Cfpintog/-Controlador-MIDI-movimiento-dedos-2016-2/README.md

# -Controlador-MIDI-movimiento-dedos-2016-2
Implementación de controlador MIDI en LM32
