Cfpintog/-Controlador-MIDI-movimiento-dedos-2016-2/proyecto-final-guante.pdf

UNIVERSIDAD NACIONAL DE COLOMBIA, DEPARTAMENTO DE INGENIERÍA ELECTRICA Y ELECTR ´ | ONICA, ELECTR ´ | ONICA DIGITAL II | 1 ´

# Proyecto Final: Guante MIDI

David Burbano, Miguel Perez, Carlos Pinto (daaburbanola@unal.edu.co, migaperezber@unal.edu.co, cfpintog@unal.edu.co)

I. INTRODUCCION´

La especificacion MIDI (Musical Interface Digital ´
Interface) surge en 1983 como un estandar t ´ | ecnico universal ´
que permitiera la comunicacion y conexi ´ | on entre equipos ´
profesionales de audio, independientemente del fabricante. Mediante un protocolo de comunicacion serial, compuesto por ´
tres bytes, fue posible el envío y recepcion de informaci ´ | on´
asociada a un instrumento musical específico, su volumen (velocity), tono, paneo, etc.
En principio este protocolo fue concebido para instrumentos musicales cuyas características de diseno digital consistiera en ˜ Hardware, sin embargo, debido a un desarrollo paralelo de los computadores personales como instrumentos de produccion´
de audio, el protocolo MIDI tomo un enfoque de co-dise ´ | nõ
HW/SW que resulta interesante para el objetivo del curso.
II. | DESCRIPCION DEL DISPOSITIVO ´ | .

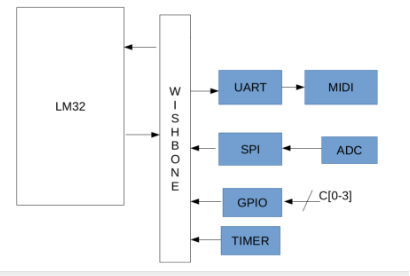
[picture p1: figure]

Figura 1. Bloque estructural

El dispositivo se plantea como un instrumento musical en el cual la activacion de las notas se hace por medio ´ de movimiento de los dedos, usando un guante que tendrá incorporado sensores fotoelectricos, dispuestos de tal forma ´ que capten el movimiento de los dedos del usuario.
Una vez captada la posicion de los dedos, esta es procesada ´ para luego ser enviada a modo de mensaje de protocolo MIDI, el cual es transmitido por medio de UART a un circuito acondicionador, el cual eleva los niveles logicos ´ característicos de la FPGA a los 5V logicos necesarios para ´ el funcionamiento del sistema MIDI, mensajes que seran´ interpretados por una interfaz para luego ser reenviados a el dispositivo de reproduccion. ´
Debido a las características del protocolo MIDI ya que es el protocolo usado de manera profesional para aplicaciones musicales de alta fidelidad, se cuentan con diversas opciones, tales como cambiar el paneo (Distribucion espacial del ´ sonido), la velocidad de la nota, el instrumento a emular en el dispositivo reproductor de sonido y se puede variar entre 127 notas diferentes.
En nuestro caso en especifico se cuenta con la seleccion de ´ 8 distintas notas, estas debido a las diferentes combinaciones
posibles de los dedos indice, corazon, anular y me ´ | nique; ˜
Ademas se cuenta con la opcion de cambiar el nivel de ´ volumen, esta senal depende del valor medido en un potencio ˜ metro, el cual es cambiado a valores digitales por medio de un conversor Analogo-Digital, el cual se comunica con la FPGA por medio de protocolo SPI, y de la misma manera que la nota, es enviado por medio de MIDI a el dispositivo de reproduccion. ´

III. ESPECIFICACIONES SOFTWARE/HARDWARE

A continuacion se presenta informaci ´ | on detallada sobre las ´
especificaciones HW/SW del proyecto.

Especificaciones de Software

Analisis de se ´ | nales provenientes de sensores: ˜

Uno de los aspectos fundamentales del proyecto consiste en
que al recibir una senal espec ˜ | ífica de un actuador, el sistema
este en capacidad de analizar dicha se ´ | nal, saber de d ˜ | onde ´
proviene, y realizar una tarea específica a partir del analisis ´ de la misma. En este caso la senal el ˜ ectrica proveniente del ´ ADC es digitalizada, y posteriormente enviada a la FPGA. El
analisis de la se ´ | nal y la ejecuci ˜ | on de una acci ´ | on espec ´ | ífica
son procesos que resultan mas viables desde una perspectiva ´ de diseno de software. En este caso, el procesador montado en ˜ la FPGA debe estar en la capacidad de determinar la intensidad (o nivel) de la senal proveniente del sensor, y a partir de esto ˜ asignar un nivel del volumen.
Adicionalmente, considerando que el proyecto hace uso de cuatro fototransistores anadidos al guante, el software debe ˜ estar en capacidad de determinar el origen de la senal digital. A ˜ partir de este analisis se decide que nota se asigna identificadas ´ con un valor en el protocolo MIDI.

Especificacion de Hardware ´
Perifericos para ADC: La conversi ´ | on de se ´ | nales anal ˜ | ogicas ´
y digitales requiere de la utilizacion de circuitos integrados ´ que pasen del dominio discreto digital, al dominio continuo analogo y viceversa. Para el caso de los conversores ADC, ´ basta con la utilizacion de circuitos ADC de 8 bits. Esto debido ´ a que el protocolo MIDI tiene un rango de maximo 7 bits para ´ el nivel (velocity).

UNIVERSIDAD NACIONAL DE COLOMBIA, DEPARTAMENTO DE INGENIERÍA ELECTRICA Y ELECTR ´ | ONICA, ELECTR ´ | ONICA DIGITAL II | 2 ´

Los demas elementos de hardware van asociados a los ´
perifericos de comunicacion usados: ´
SPI
UART
GPIO
TIMER

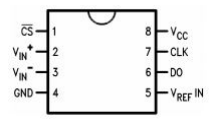
[picture p2: figure]

Figura 2. IC del conversor Analogo-Digital ADC08031. ´

IV. PERIFERICOS UTILIZADOS ´ | , DESCRIPCION Y ´

FUNCIONAMIENTO.

UART

La UART (Universal Asynchronous Receiver/Transmitter) corresponde a un Hardware que traduce informacion de serial ´ a paralelo y viceversa. Lo anterior quiere decir que la UART
toma informacion paralela en forma de Bytes, y env ´ | ía bit por
bit de esta informacion de manera secuencial. ´
Esto implica la definicion de ciertas condiciones de manera ´ que tanto emisor como receptor puedan comunicarse de
manera adecuada. Primero, la comunicacion es as ´ | íncrona,
esto significa que no existe una senal de reloj com ˜ | un entre ´
las dos partes que se comunican. Segundo, se requieren bits de inicio y de parada de manera que las dos partes sepan en
que momento se da inicio y finalizacion a la transmisi ´ | on de ´
datos. Tercero, se utiliza un unico lazo para la transmisi ´ | on´
y recepcion de informaci ´ | on, lo que significa que no existe ´
ninguna de las partes actua como maestro o esclavo. ´
Para el proyecto se parte de una UART disenada previamente ˜ teniendo en cuenta la compatibilidad con el Wishbone del LM32, este periferico se implemento para lograr la ´ transmision del mensaje MIDI; mensaje que puede ser ´ transmitido por medio de una interfaz MIDI o por medio de bluetooth usando el modulo HC-06, pero dicha transmision´ no puede ser reconocida por la dificultad para cambiar la velocidad de transmision de datos por parte del modulo ´ de bluetooth ya que MIDI utiliza una velocidad de 31250 baudios.
En la figura IV se puede observar el diagrama funcional de UART en donde vemos las senales involucradas tanto ˜
en el proceso de transmision como en recepci ´ | on, en el ´
caso especifico de esta aplicacion solo es usada la funci ´ | on´
de UART-tx, ya que este periferico solo es usado para ´ transmision del mensaje MIDI; Ademas que la frecuencia de ´
envio debi ´ | o ser dispuesta a 31250 baudios. ´

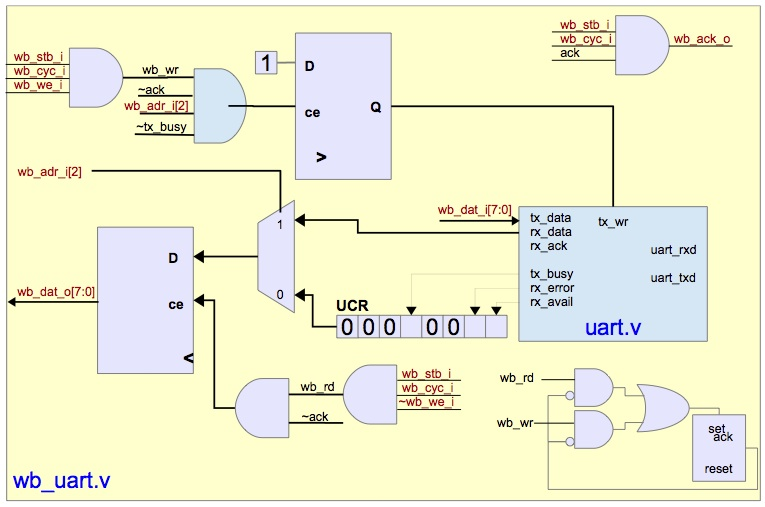
[picture p3: figure]

Figura 3. Diagrama logico de perif ´ | erico UART. ´

SPI
Para el correcto funcionamiento del proyecto es necesario recibir de manera adecuada una senal an ˜ aloga proveniente del ´ control de volumen, para esto se hace necesaria la implemen-tacion de un conversor AD, usando el ADC0831 el cual tiene ´ una salida serial y se comunica con el procesador por medio de protocolo SPI.
El SPI tiene una comunicacion s ´ íncrona y utiliza líneas sepa-radas para los datos y el reloj que mantiene a ambos lados en sincronía. Cuenta con 4 senales propias, CLK (reloj), la ˜
senal MOSI (Master Output - Slave Input), la se ˜ | nal MISO ˜
(Master Input - Slave Output) y un SS (select Slave) o CS. Al producirse una senal de reloj es seleccionado el esclavo ˜ con la senal SS, la cual al estar inactiva se encuentra en un ˜ estado logico alto y en el momento en el que es seleccionado ´
un esclavo la senal SS se pone en estado bajo. Las l ˜ | íneas de
datos son enviadas en orden. Primero el dato de transmision, ´
aquel que va por la sena MOSI, y luego el dato de recepci ˜ | on´
que va por la senal MISO. Este proceso descrito anteriormente ˜ se ilustra en la figura IV.

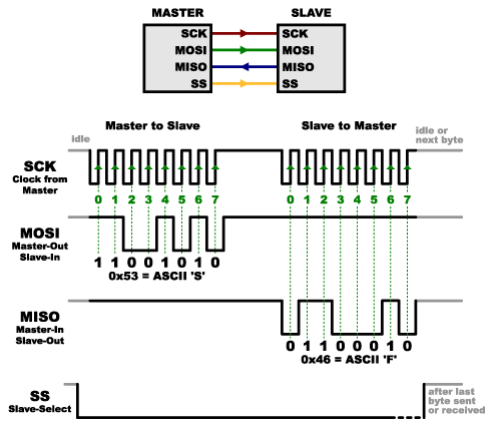
[picture p4: figure]

Figura 4. Diagrama de transmision SPI. ´

Timer
El periferico TIMER es un hardware que permite al usuario ´ implementar un control para la generacion de bases de tiem- ´ pos. Tiene la capacidad de realizar funciones como medicion´ de frecuencia, conteo de eventos, conteo de intervalos, generacion de reloj. etc. En la figura se observa la estructura del ciclo ´

UNIVERSIDAD NACIONAL DE COLOMBIA, DEPARTAMENTO DE INGENIERÍA ELECTRICA Y ELECTR ´ | ONICA, ELECTR ´ | ONICA DIGITAL II | 3 ´

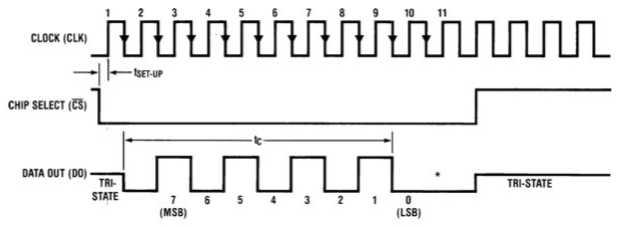
[picture p5: figure]

Figura 5. Funcionamiento 0831.

de lectura y escritura del periferico TIMER. Este perif ´ | erico ´
posee 6 registros y la posibilidad de leer al tiempo estas 6 variables. El timer cuenta con un contador, un comparador y un “tcr” de 32 bits, este registro contiene los bits EN, AR, IRQEN Y TRIG, los cuales corresponden a bits de control. El registro compare (comparador) de 32 bits contiene el tiempo o dato en el que se ha definido el retraso, de esta forma, al obtener el valor de compare, se activa el bit EN el cual inicia el conteo. Una vez el contador alcanza el valor compare se activa el bit AR y se reinicia el contador en 1. las variables son
posteriormente enviadas al wishbone por la senal wb ˜ | dat o.
En la fig. 12 se muestra el funcionamiento del periferico ´ TIMER. Para el desarrollo del proyecto, se implemento un ´ timer o retraso en los mensajes de desactivacion de nota, con ´ el objetivo de permitir que la nota o sonido sea reproducida durante un tiempo mas largo, de lo contrario la nota solo ´ duraría el tiempo que el procesador toma en leer el mensaje
de desactivacion de nota lo cual equivaldr ´ | ía a un tiempo muy
pequeno. ˜

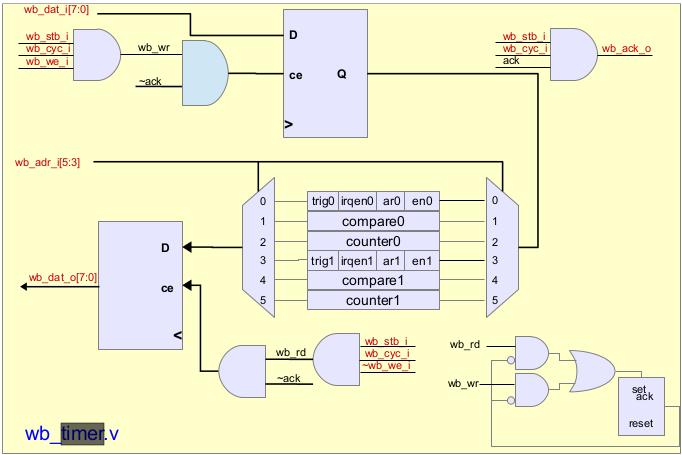
[picture p6: figure]

Figura 6. Comunicacion Perif ´ | erico TIMER- Lm32 ´

GPIO
El periferico GPIO es un perif ´ | erico de pines de entrada y ´
salida de proposito general. Permite controlar la direcci ´ | on de ´
un pin, controlar el valor de un pin de salida y leer el valor de un pin de entrada. En la siguiente figura se muestra el funcionamiento interno del periferico GPIO. ´
Para el desarrollo del proyecto se implemento un GPIO que ´ a traves de unos interruptores en la tarjeta de desarrollo per- ´ mita cambiar de instrumentos de acuerdo con la especificacion´ midi. Esto con el objetivo de que el proyecto no tenga solo funcionalidad de batería sino que tambien pueda sonar como ´ diferentes instrumentos seleccionados a traves del GPIO. Una ´ de las importantes capacidades del GPIO es la capacidad de leer valores de entrada (por lo general alto = 1, bajo = 0).

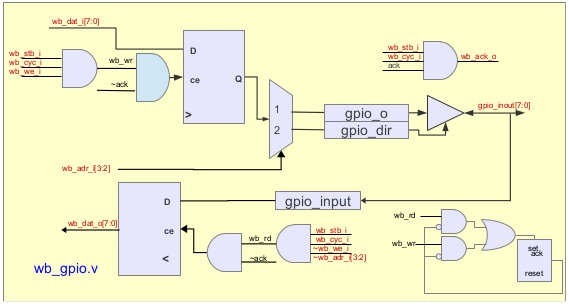
[picture p7: figure]

Figura 7. Comunicacion Perif ´ | erico GPIO- Lm32 ´

Teniendo en cuenta esta funcionalidad, para este GPIO se utilizaron 8 interruptores de la Nexys 4, estos 8 interruptores corresponden cada uno a un bit ( sea 0 o 1) seleccionado a partir del usuario, lo cuales permiten un rango de 0-255 en numero binario que corresponde en total a 255 diferentes ´ sonidos de instrumentos musicales.

V. PROTOCOLO MIDI

MIDI (abreviatura de Musical Instrument Digital Interface)
es un estandar tecnol ´ | ogico que describe un protocolo, ´
una interfaz digital y conectores que permiten que varios instrumentos musicales electronicos, computadoras y otros ´ dispositivos relacionados se conecten y comuniquen entre sí.1 Una simple conexion MIDI puede transmitir hasta ´
dieciseis canales de informaci ´ | on que pueden ser conectados ´
a diferentes dispositivos cada uno.

El sistema MIDI lleva mensajes de eventos que especifican
notacion musical, tono y velocidad; se ´ | nales de control para ˜
parametros musicales como lo son la din ´ | amica, el vibrato, ´
paneo, cues y senales de reloj que establecen y sincronizan el ˜ tempo entre varios dispositivos. Estos mensajes son enviados mediante un cable MIDI a otros dispositivos que controlan
la generacion de sonidos u otras caracter ´ | ísticas. Estos datos
tambien pueden ser grabados en un hardware o software ´ llamado secuenciador, el cual permite editar la informacion y ´ reproduciría posteriormente.
Un mensaje MIDI es una instruccion que controla alg ´ | un´
aspecto del dispositivo receptor. Un mensaje MIDI consiste en un byte de estatus, el cual indica el tipo del mensaje, seguido de dos bytes de datos que contienen los parametros.20 ´ Los mensajes MIDI pueden ser ”mensajes de canal”, los cuales son enviados a unos de los dieciseis canales y puede ´ ser escuchado solo por los dispositivos en ese canal, o ”mensajes de sistema”, los cuales pueden ser escuchados por todos los dispositivos. Cualquier dato no relevante para un dispositivo receptor es ignorado.37 :384 Existen cinco tipos de mensajes: Ç hannel Voice”, Ç hannel Mode”, ”System Common”, ”System Real-Time ²
”System Exclusive” En
la figura V podemos observar la conexion con la interfaz ´ MIDI, la cual como se observa parte de la senal proveniente ˜ de UART enviada por el procesador que se pasa por un amplificador dc-dc en el cual la senal es elevada a los valores ˜
logicos admitidos por MIDI, y se realiza la conexi ´ | on a el ´

UNIVERSIDAD NACIONAL DE COLOMBIA, DEPARTAMENTO DE INGENIERÍA ELECTRICA Y ELECTR ´ | ONICA, ELECTR ´ | ONICA DIGITAL II | 4 ´

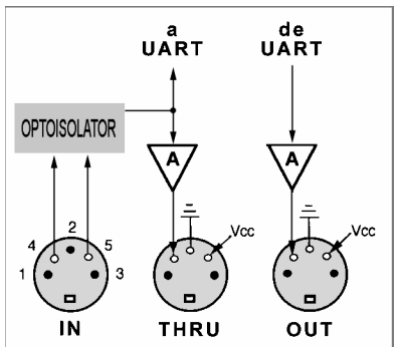
[picture p8: figure]

Figura 8. Esquema de conector MIDI

dispositivo, el cual tiene 5 pines, de los cuales solo se usan 3. Con respecto al mensaje MIDI, este esta compuesto por

Figura 9. Mensaje MIDI

3 bytes, como se indica en la figura V en los cuales el primer byte indica el tipo de mensaje a ser enviado, y los siguientes dos son para transmitir los datos, por ejemplo,
para la activacion de una nota el primer byte indicar ´ | ía que se
quiere activar una nota, el segundo el numero de la nota(mirar figura V), y el tercero su velocidad.
Para la transmision del mensaje MIDI, se emplea de la forma ´

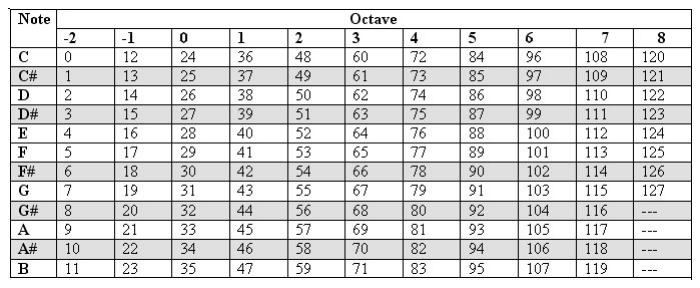
[picture p9: figure]

Figura 10. Tabla de notas protocolo MIDI

especificada en V:

Figura 11. Mensaje midi para activaccion de nota ´

Donde el valor 0x90 representa el mensaje de la activacion´ de una nota en el canal 0. El siguiente Byte corresponde a la nota seleccionada por el guante, finalmente el ultimo byte especifica la velocidad de ataque que indica que tan fuerte se esta presionando una tecla. Por defecto este valor se coloca en 0x40, para desactivar una nota se envía un 0x00 en este byte.

Para el cambio de volumen se emplea el mensaje especificado en V.

Figura 12. Mensaje midi para variacion de volumen ´

El primer byte representa un mensaje de cambio de control, que permite interactuar de distintas maneras con la calidad del sonido. El segundo byte corresponde al tipo de control que se va a emplear, en este caso es un cambio de volumen. Finalmente el ultimo byte corresponde al valor del volumen de la nota.
