Cfpintog/-Controlador-MIDI-movimiento-dedos-2016-2/proyecto digital 1.0.pdf

# Controlador MIDI aplicado al movimiento de los dedos

## David Burbano Miguel Pérez Carlos Pinto

## Descripción:

Se plantea el diseño de un un instrumento musical, el cual permite al usuario interactuar con el equipo por medio de un guante.
Y mediante el movimiento de sus dedos activar diferentes sonidos, con una frecuencia y tono diferente para cada uno de los dedos; lo cual permitirá al usuario por medio de diferentes combinaciones de movimientos crear distintas melodías y ritmos.

## Especificaciones del sistema

El dispositivo debe ser capaz de realizar las siguientes operaciones:

-Sensado del movimiento de cada uno de los dedos del usuario.

-Tener la posibilidad de elegir entre 3 tipos de instrumento.

-Por medio de UART se debe realizar el envío de mensajes al sistema MIDI

-Debe reproducirse el sonido elegido en los amplificadores de audio de un PC

## Componentes

Procesador LM32

5 sensores (infrarrojo) [S0-S4] (flexión- extensión)

1 Sensor (fotodetector)

1 Conmutador (selección de instrumento)[C0-C3]

## Modo de operación

Se determina el tipo de instrumento a interpretar C1, C2, C3

Se lee los valores de los sensores [s0-s4] y se selecciona la nota dependiendo del valor en la tabla.

A partir de la lectura del valor del ADC se determina el volumen de la nota.

Se transmiten los datos por UART.

## Diagrama estructural

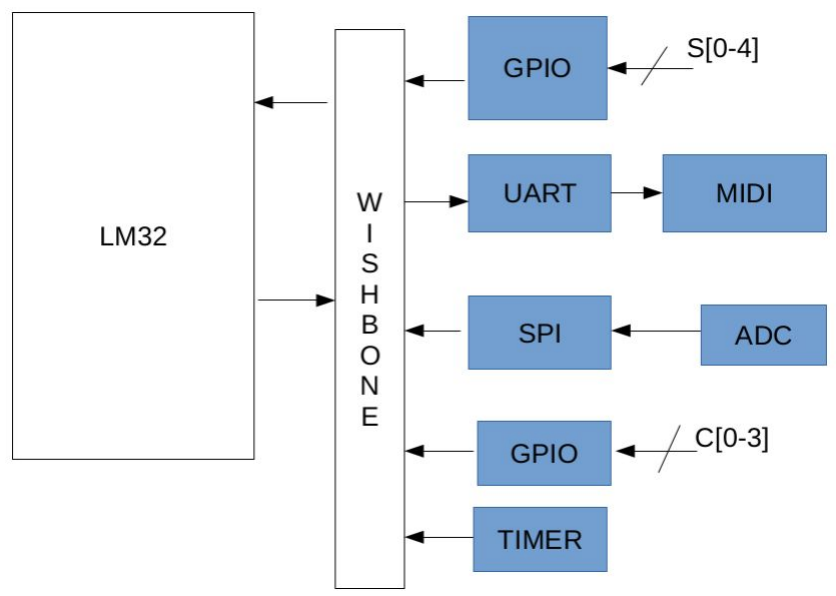
[picture p10: figure]

## Diagrama funcional(instrumento)

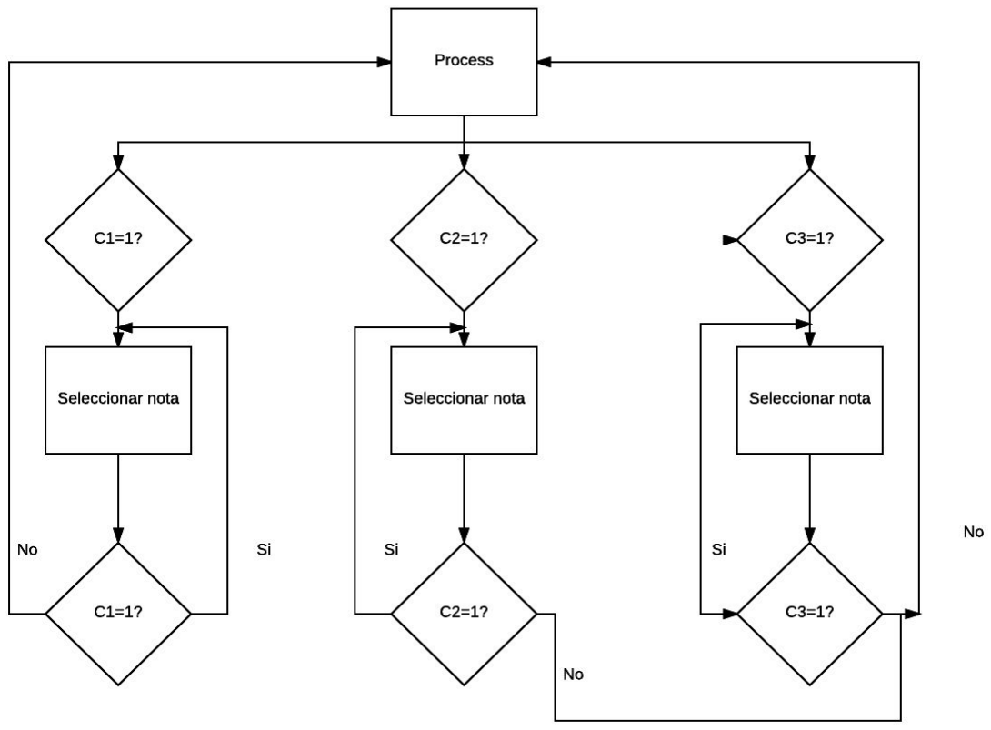
[picture p11: figure]

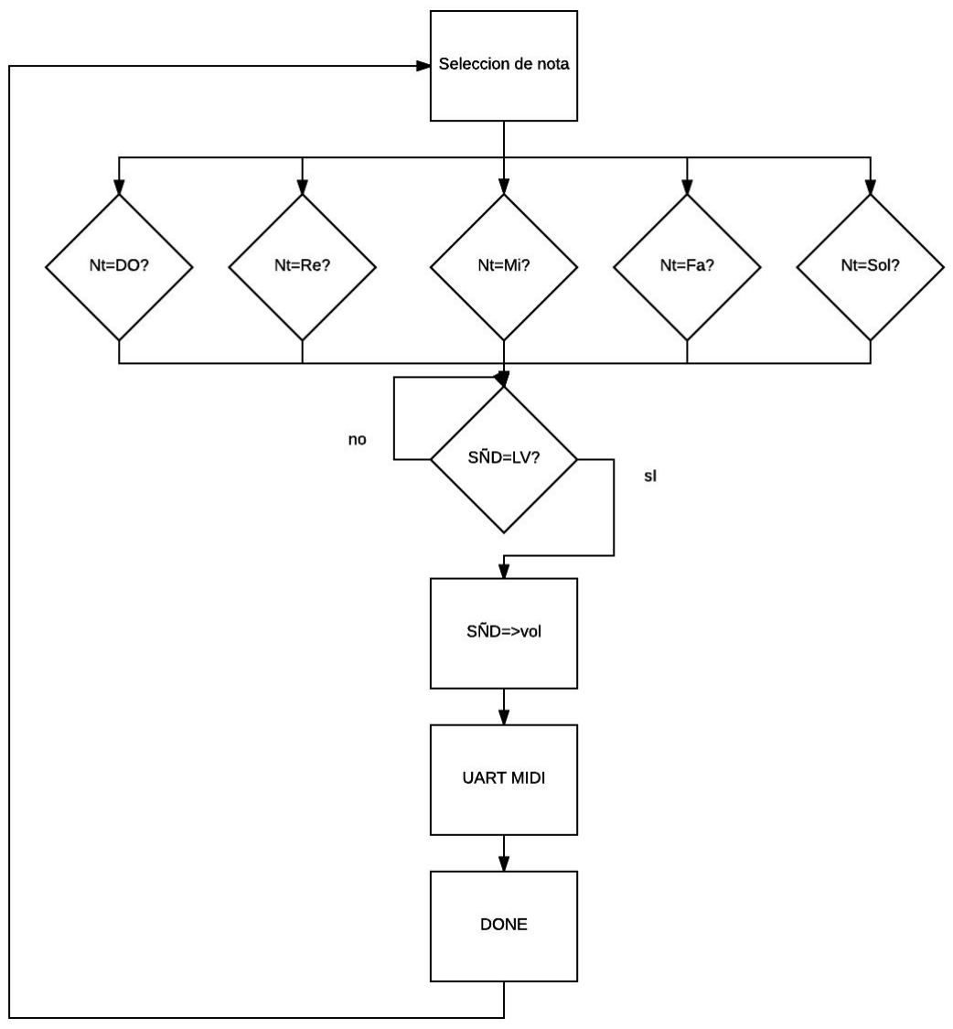
[picture p12: figure]

## Diagrama funcional

La variable LV representa el nivel de volumen que se encuentra en la base de datos, cuando el procesador ha asignado la señal eléctrica a un nivel de volumen, este crea una señal digital correspondiente a un mensaje MIDI definido, la cual será enviada por medio de la UART a una interfaz de audio MIDI, completando el flujo de señal. Una vez la señal es enviada según la especificación MIDI, debe poder ser utilizada, reproducida, capturada por cualquier equipo que también cumpla con la especificación MIDI.

## Conversor ADC0831

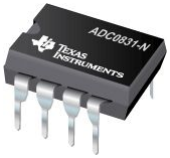
[picture p13: figure]

## Diseño

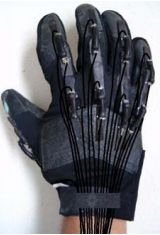
[picture p14: figure]
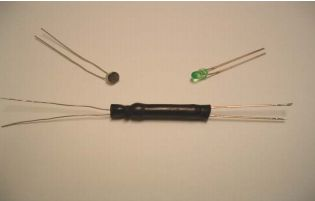
[picture p15: figure]

## SPI

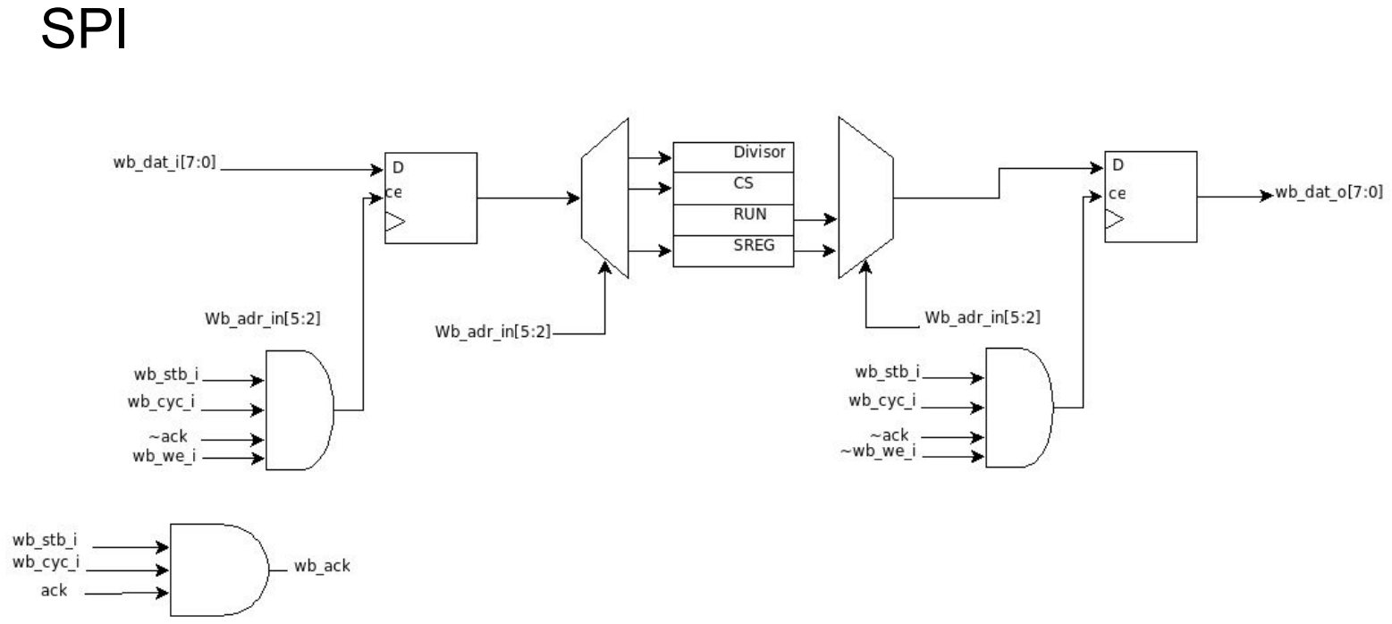
[picture p16: page 11]

## SPI

## SPI

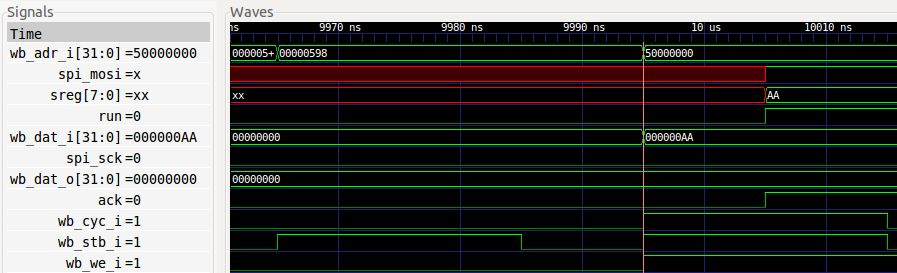
[picture p17: figure]

## SPI

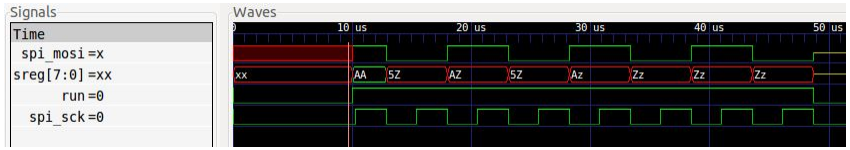
[picture p18: figure]

## SPI

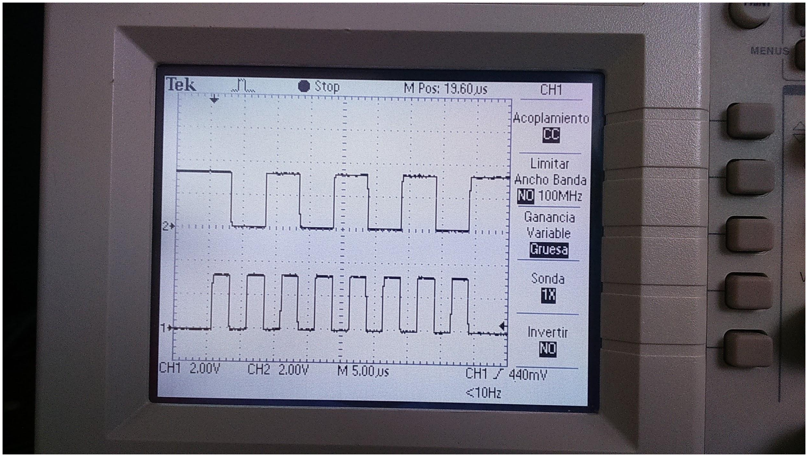
[picture p19: figure]

## Bibliografía

-LEYBON Ibarra; Sensor Fotoeléctrico Aplicado Al Movimiento De Los Dedos, Instituto nacional de rehabilitación, México DF [online] http://www.ejournal.unam.mx/cys/vol10-01/CYS10105.pdf

-MONDRAGON Andres, RODRIGUEZ Luis; Controlador MIDI a Partir de Sensores Piezoeléctricos; Universidad Nacional, Bogotá, Colombia [online]

https://sites.google.com/site/edigital2unal/proyectos/proyectos_i-015/grupo07
