Cfpintog/-Controlador-MIDI-movimiento-dedos-2016-2/(commit log)

2016-09-07 Add files via upload
    Descripción SPI
2016-09-07 Add files via upload
    cambio mapa de direcciones
2016-09-14 actualización spi0
    declaración de funciones y prueba
2016-09-14 Add files via upload
    Actualización spi
2016-09-14 actualización spi
